chili-chips-ba/openPCIE/(notices)

Notices in the files:
1.pcb/openpci2-backplane/pcie_switch.kicad_sch:
COPYRIGHT (C) CHILI.CHIPS.LLC
https://cern-ohl.web.cern.ch
Licensed under CERN-OHL-P v2
1.pcb/openpci2-backplane/openpci2-backplane.kicad_pcb:
CERN-OHL-P
